Waheed7000/ESP-32_with_OLED_Screen_present/docs/esp-32 with 1.3insh OLED screen gift vr4 mirrored.png

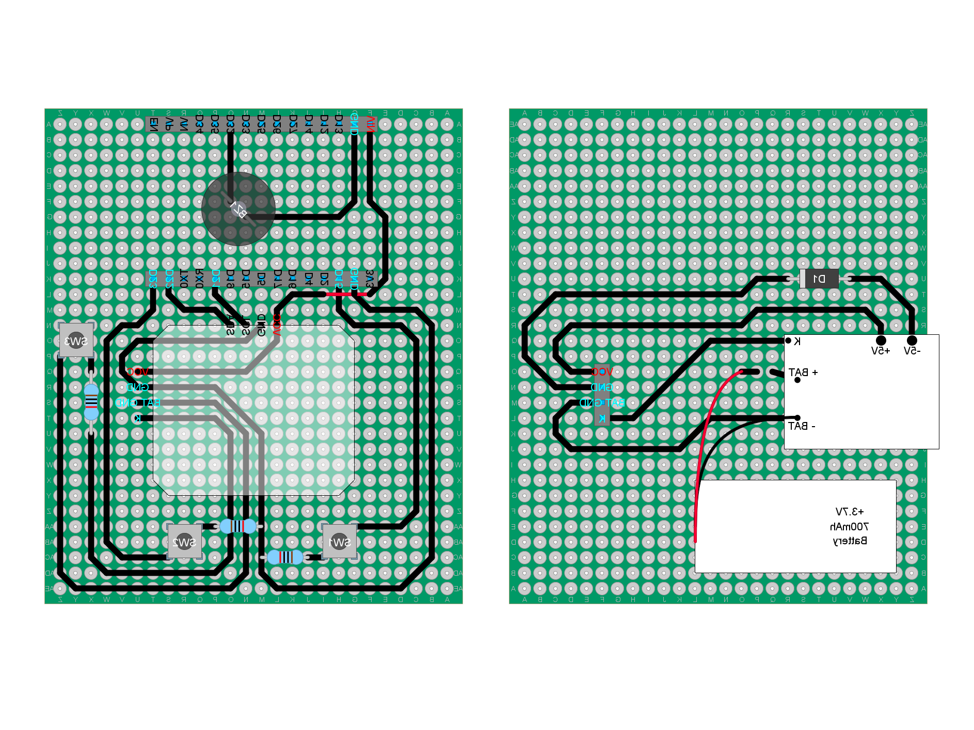
docs/esp-32 with 1.3insh OLED screen gift vr4 mirrored.png
